sujaygarlanka/AutoBot/older_versions/README.md

# AutoBot (Older Versions)
In this folder is code and details for the older versions of the TennisBot

## v0.0
This version was the RC car that could be controlled via the iPhone.

The overall design was an hArduino controlling the car, a Bluetooth module communicating to the Arduino via the serial ports, and the iPhone sending commands over Bluetooth to the Bluetooth module. 

### Software
 - Code on Arduino found in the `v0/arduino` folder
 - iPhone app found in `v0/ios` folder

### Hardware
#### Parts
- [RC Car - Monster Jam Grave Digger 1:15](https://www.amazon.com/Monster-Jam-Official-Remoter-Control/dp/B07HGR66Q5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)
- [Motor Controller - l298n](https://www.amazon.com/Controller-Module-Bridge-Stepper-Arduino/dp/B07RB2LWD7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)
- [Bluetooth transceiver (Connects to iPhone)](https://www.amazon.com/gp/product/B06WGZB2N4/ref=ppx_yo_dt_b_asin_title_o00_s00?ie=UTF8&psc=1)
- [Batteries](https://www.amazon.com/gp/product/B083K4XSKG/ref=ppx_yo_dt_b_asin_title_o02_s00?ie=UTF8&psc=1)
- [Battery holder](https://www.amazon.com/gp/product/B0858WTZM7/ref=ppx_yo_dt_b_asin_title_o01_s00?ie=UTF8&psc=1)
- [Switches](https://www.amazon.com/5Pcs-Rocker-Switch-Position-QTEATAK/dp/B07Y1GDRQG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)

### Resources
#### Bluetooth
- Guides for Bluetooth connection between iPhone and HM-10
    - http://www.hangar42.nl/hm10
    - https://www.freecodecamp.org/news/ultimate-how-to-bluetooth-swift-with-hardware-in-20-minutes/
- Bluetooth commands: https://drive.google.com/file/d/17Zf_pb6ikwaUtI67UDObh17c07OQFQOh/view

## v1.0
This version was the RC car that could be controlled over Wifi by a computer on the same network as the car.

The overall design was an Raspberry Pi controlling the car that could connect over Wifi to a python server on a computer on the same network that would send it commands.

### Software
 - Code on Raspberry Pi found in the `v1/raspberry_pi` folder
 - Python server code found at `v1/server.py`

### Hardware
#### Parts
- [RC Car - Monster Jam Grave Digger 1:15](https://www.amazon.com/Monster-Jam-Official-Remoter-Control/dp/B07HGR66Q5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)
- [Motor Controller - l298n](https://www.amazon.com/Controller-Module-Bridge-Stepper-Arduino/dp/B07RB2LWD7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)
- [Raspberry Pi Zero Wireless](https://www.amazon.com/CanaKit-Raspberry-Wireless-Complete-Starter/dp/B072N3X39J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)
- [Batteries](https://www.amazon.com/gp/product/B083K4XSKG/ref=ppx_yo_dt_b_asin_title_o02_s00?ie=UTF8&psc=1)
- [Battery holder](https://www.amazon.com/gp/product/B0858WTZM7/ref=ppx_yo_dt_b_asin_title_o01_s00?ie=UTF8&psc=1)
- [Switches](https://www.amazon.com/5Pcs-Rocker-Switch-Position-QTEATAK/dp/B07Y1GDRQG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)

### Resources
- Guidance on how to setup Raspberry Pi: https://github.com/sujaygarlanka/DrinkMixr-Raspberry-Pi
