sujaygarlanka/AutoBot/ios/people.jpg

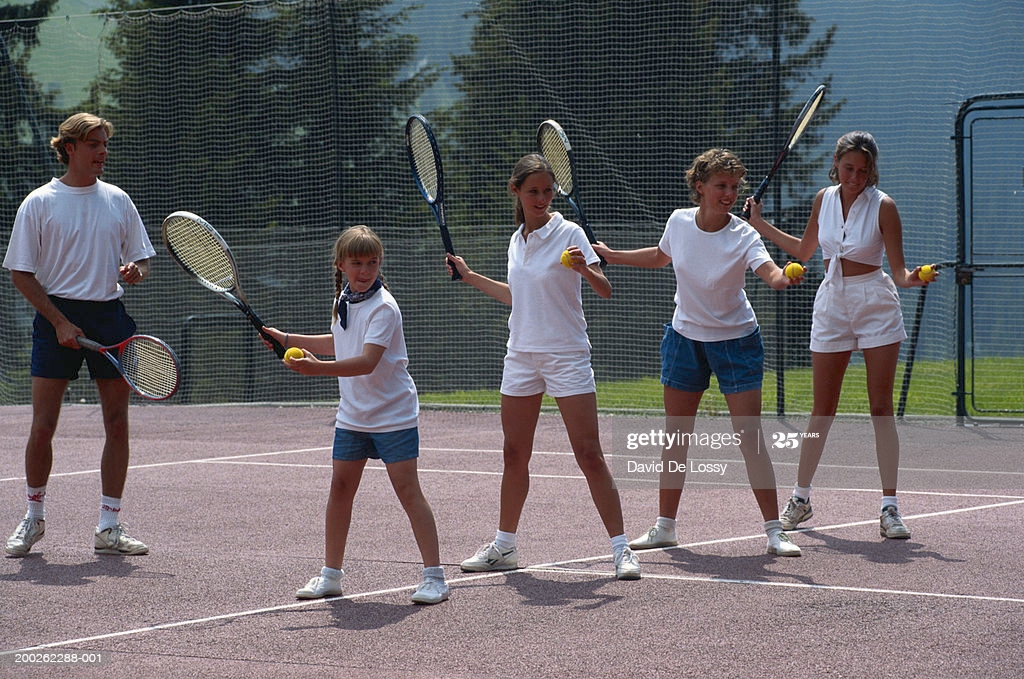
ios/people.jpg
