sujaygarlanka/AutoBot/server/object_detection/yolov3_pytorch/images/far_tags.jpg

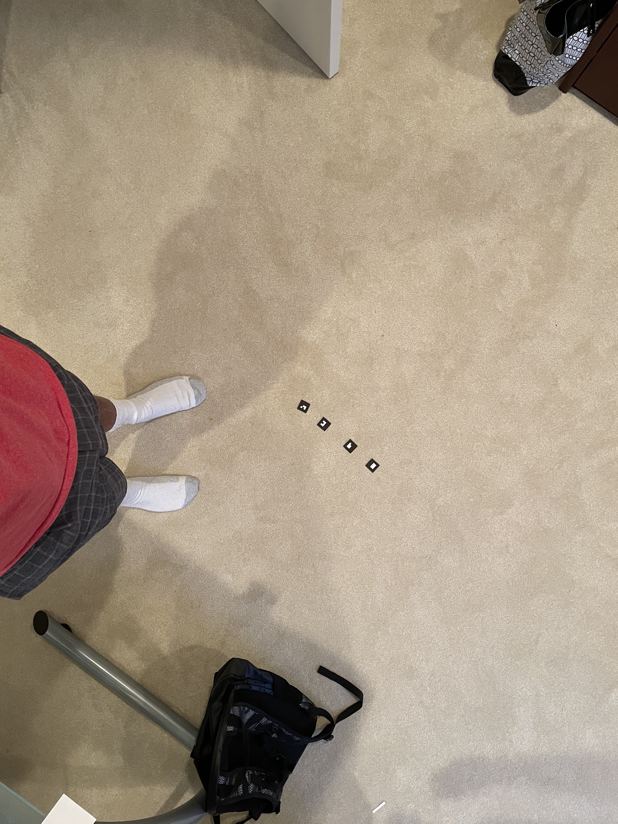
server/object_detection/yolov3_pytorch/images/far_tags.jpg
