sujaygarlanka/AutoBot/server/object_detection/yolov3_pytorch/images/IMG_0772.jpeg

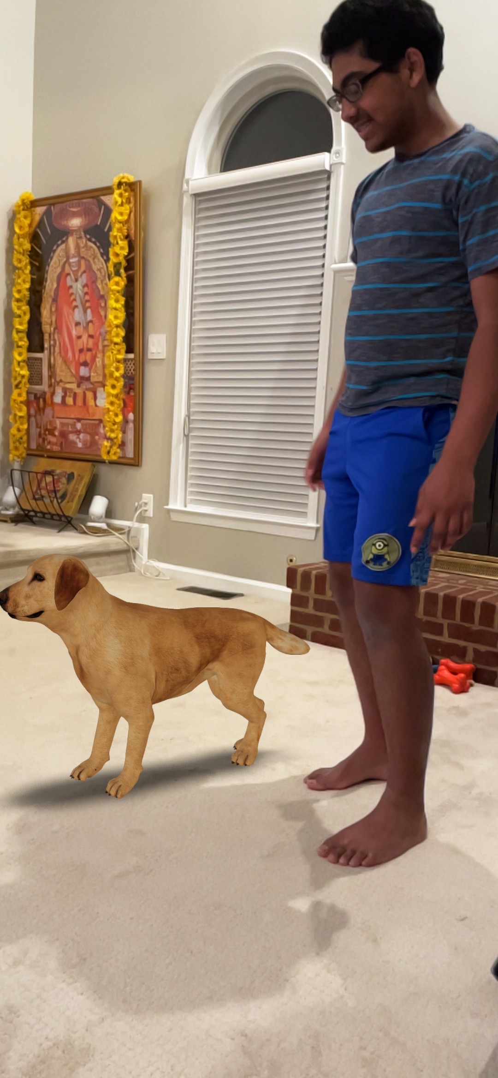
server/object_detection/yolov3_pytorch/images/IMG_0772.jpeg
