sujaygarlanka/AutoBot/server/object_detection/yolov3_pytorch/images/tags.jpg

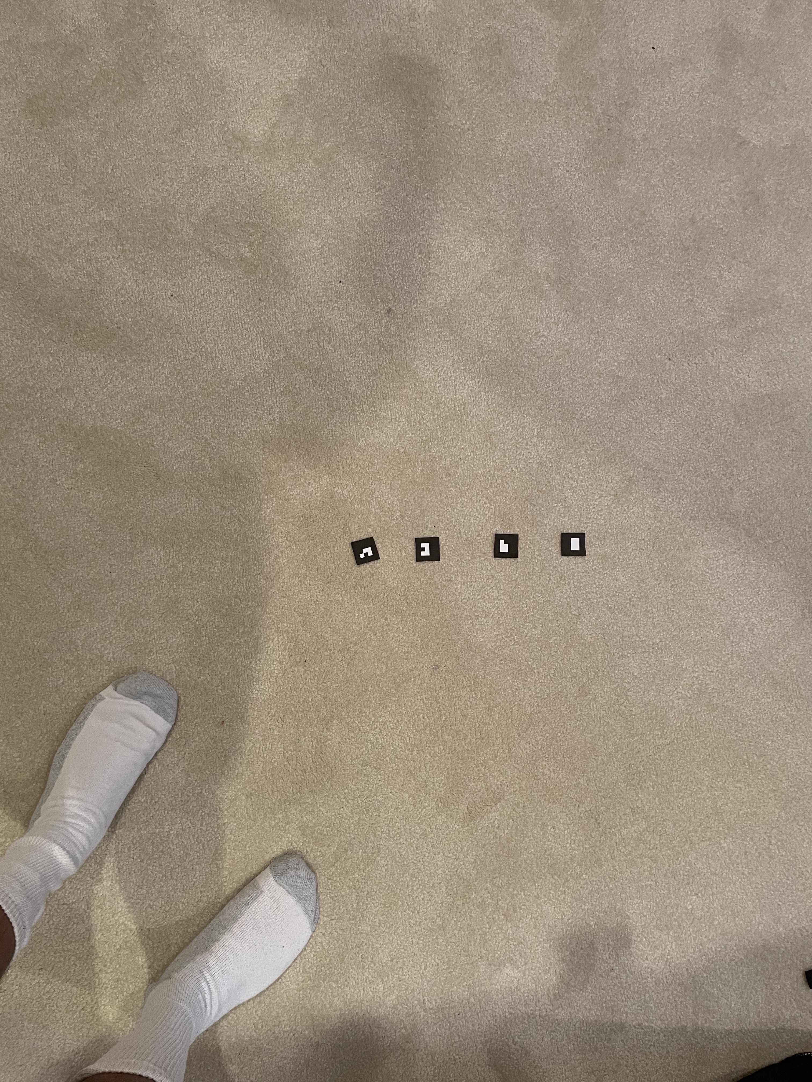
server/object_detection/yolov3_pytorch/images/tags.jpg
