sujaygarlanka/AutoBot/server/object_detection/yolov3_pytorch/images/test.jpg

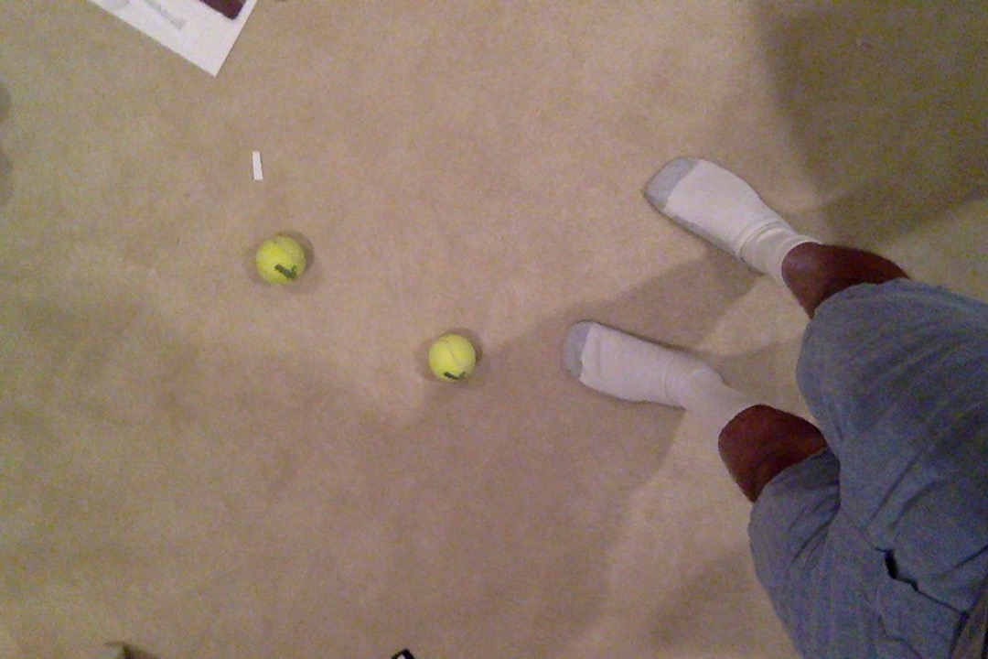
server/object_detection/yolov3_pytorch/images/test.jpg
