sujaygarlanka/AutoBot/(commit log)

2021-04-09 add raspberry pi code
2021-04-22 reorg repo and add code to control car with argon board
2021-04-23 (actual) reorg repo and add code to control car with argon board
